tronicbaumi/PicoDeck/doc/Screenshot 2026-10-23 151857.png

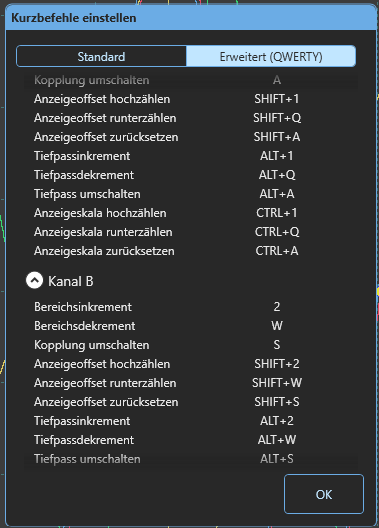
doc/Screenshot 2026-10-23 151857.png
