tronicbaumi/PicoDeck/doc/Screenshot 2026-10-23 152018.png

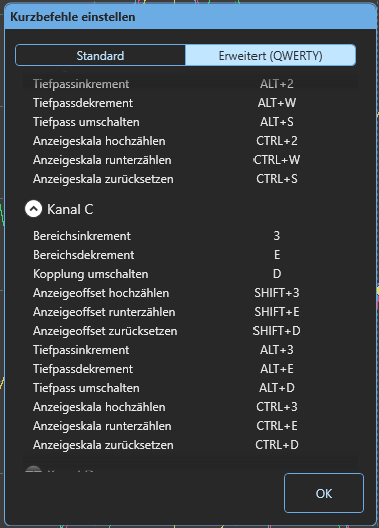
doc/Screenshot 2026-10-23 152018.png
