tronicbaumi/PicoDeck/doc/Screenshot 2026-10-23 152101.png

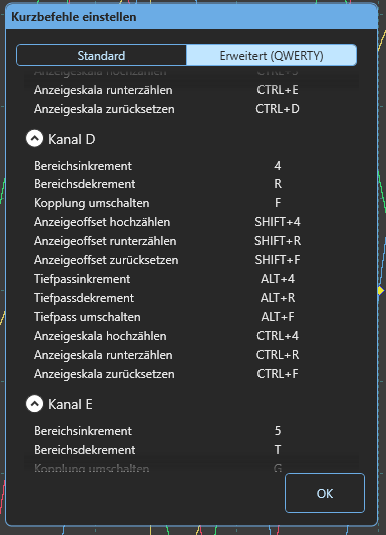
doc/Screenshot 2026-10-23 152101.png
