tronicbaumi/PicoDeck/doc/Screenshot 2026-10-23 153557.png

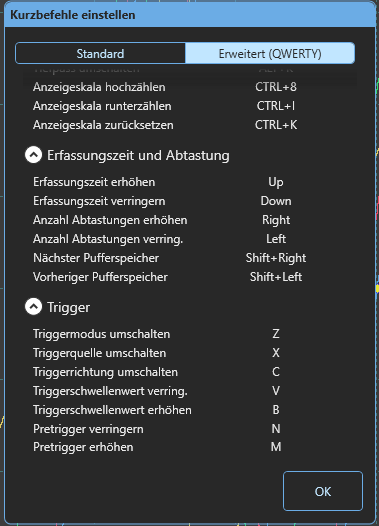
doc/Screenshot 2026-10-23 153557.png
