tronicbaumi/PicoDeck/doc/bom.txt

Arduino Micro
https://link.amazon/B075QfXTy

Buttons
https://link.amazon/B0j9Enauz

Encoder
https://link.amazon/B09QyfqTl

PCB
https://link.amazon/B01gShNRL

Buchsenleiste
https://link.amazon/B0bQtWuN1

Display
https://link.amazon/B0fDqReII

Filament
https://link.amazon/B03MNQb0l
