tronicbaumi/PicoDeck/(list of files, drawings)

Other design files:
hw/arduino_micro_panel.fz
