tronicbaumi/PicoDeck/hw/PicoDeck/PicoDeck.kicad_sch

## KiCad design hw/PicoDeck/PicoDeck.kicad_sch (2026-10-28)

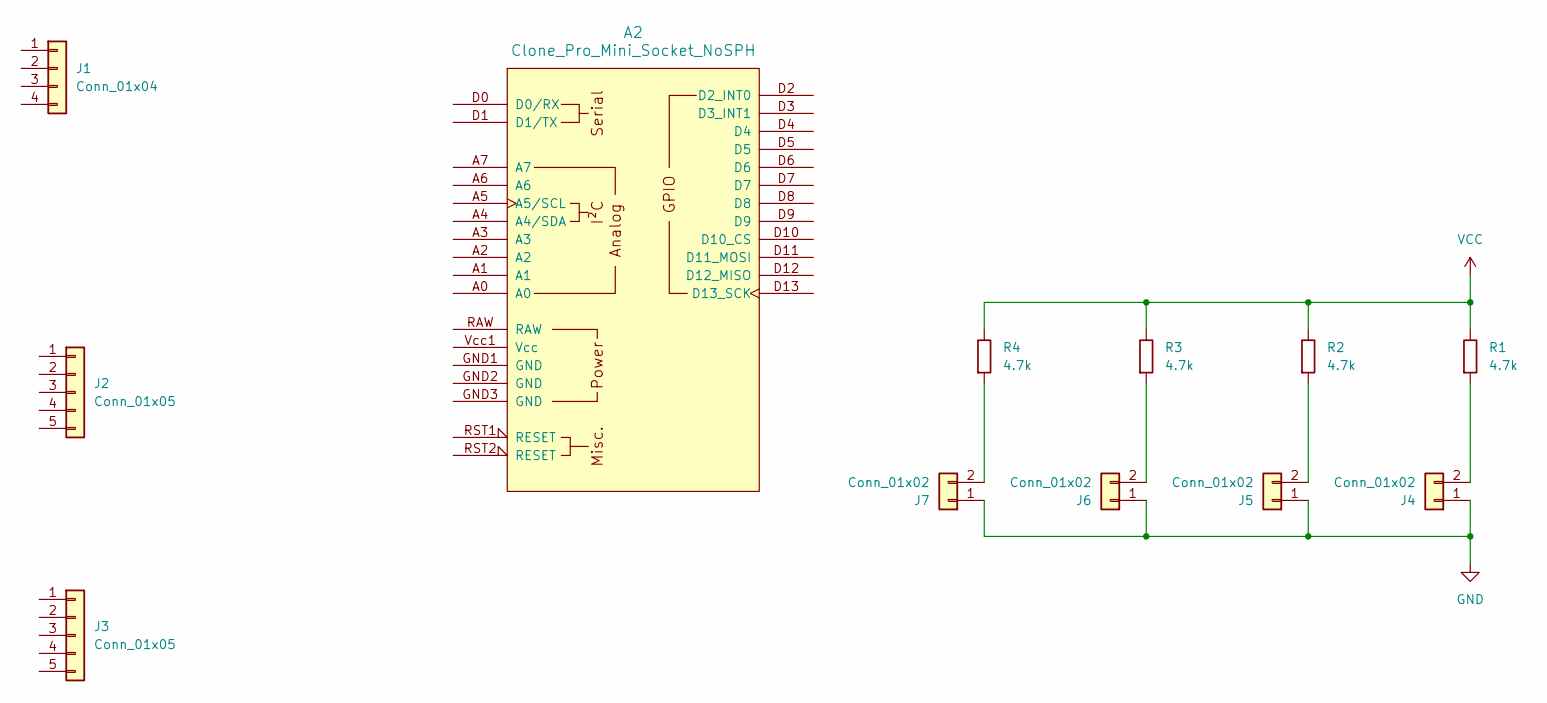
[picture p11: schematic PicoDeck.kicad_sch]

Parts:
A2: Clone_Pro_Mini_Socket_NoSPH
J1: Conn_01x04
J2, J3: Conn_01x05
J4, J5, J6, J7: Conn_01x02
R1, R2, R3, R4: 4.7k; R_Axial_DIN0207_L6.3mm_D2.5mm_P10.16mm_Horizontal

Connections:
GND: J4.1, J5.1, J6.1, J7.1
unnamed: J4.2, R1.1
unnamed: J5.2, R2.1
unnamed: J6.2, R3.1
unnamed: J7.2, R4.1
VCC: R1.2, R2.2, R3.2, R4.2
