tronicbaumi/PicoDeck/fw/PicoDeck/logo.h

// PicoScope 7 logo, 1-bit 64x64, generated from doc/PS7-logo.png
#define PS7_LOGO_WIDTH  64
#define PS7_LOGO_HEIGHT 64
static const unsigned char PROGMEM ps7_logo_bmp[] =
{
  0x00, 0x00, 0x00, 0x00, 0x00, 0x00, 0x00, 0x00, 0x0C, 0x00, 0x00, 0x00,
  0x00, 0x00, 0x40, 0x00, 0x1E, 0x0F, 0xFF, 0xF0, 0x00, 0x0F, 0xFE, 0x00,
  0x3F, 0x8F, 0xFF, 0xFC, 0x00, 0x3F, 0xFF, 0x80, 0x1E, 0x0F, 0xFF, 0xFE,
  0x00, 0x7F, 0xFF, 0xC0, 0x0E, 0x0F, 0xFF, 0xFF, 0x00, 0xFF, 0xFF, 0xE0,
  0x0E, 0x0F, 0xC0, 0x7F, 0x80, 0xFE, 0x07, 0xF0, 0x0E, 0x0F, 0x80, 0x1F,
  0xC1, 0xFC, 0x03, 0xF0, 0x0E, 0x0F, 0x80, 0x0F, 0xC1, 0xF8, 0x01, 0xF8,
  0x0E, 0x0F, 0x80, 0x0F, 0xC1, 0xF8, 0x01, 0xF8, 0x0E, 0x0F, 0x80, 0x07,
  0xC1, 0xF8, 0x00, 0x00, 0x0E, 0x0F, 0x80, 0x07, 0xC1, 0xF8, 0x00, 0x00,
  0x0E, 0x0F, 0x80, 0x07, 0xC1, 0xFE, 0x00, 0x00, 0x0E, 0x0F, 0x80, 0x0F,
  0xC0, 0xFF, 0x00, 0x00, 0x0E, 0x0F, 0x80, 0x0F, 0xC0, 0x7F, 0xE0, 0x00,
  0x0E, 0x0F, 0x80, 0x1F, 0xC0, 0x3F, 0xFC, 0x00, 0x0E, 0x0F, 0xFF, 0xFF,
  0x80, 0x1F, 0xFF, 0x00, 0x0E, 0x0F, 0xFF, 0xFF, 0x80, 0x07, 0xFF, 0xC0,
  0x0E, 0x0F, 0xFF, 0xFF, 0x00, 0x00, 0xFF, 0xE0, 0x0E, 0x0F, 0xFF, 0xFC,
  0x00, 0x00, 0x3F, 0xE0, 0x0E, 0x0F, 0xFF, 0xE0, 0x00, 0x00, 0x07, 0xF0,
  0x0E, 0x0F, 0xC0, 0x00, 0x00, 0x00, 0x03, 0xF0, 0x0E, 0x0F, 0x80, 0x00,
  0x00, 0x00, 0x01, 0xF8, 0x0E, 0x0F, 0x80, 0x00, 0x03, 0xF0, 0x01, 0xF8,
  0x0E, 0x0F, 0x80, 0x00, 0x03, 0xF0, 0x01, 0xF8, 0x0E, 0x0F, 0x80, 0x00,
  0x01, 0xF8, 0x01, 0xF8, 0x0E, 0x0F, 0x80, 0x00, 0x01, 0xFC, 0x03, 0xF0,
  0x0E, 0x0F, 0x80, 0x00, 0x01, 0xFF, 0x0F, 0xF0, 0x0E, 0x0F, 0x80, 0x00,
  0x00, 0xFF, 0xFF, 0xE0, 0x0E, 0x0F, 0x80, 0x00, 0x00, 0x7F, 0xFF, 0xC0,
  0x0E, 0x0F, 0x80, 0x00, 0x00, 0x1F, 0xFF, 0x80, 0x0E, 0x0F, 0x80, 0x00,
  0x00, 0x03, 0xFE, 0x00, 0x0E, 0x00, 0x00, 0x00, 0x00, 0x00, 0x00, 0x00,
  0x0E, 0x00, 0x00, 0x00, 0x00, 0x00, 0x00, 0x00, 0x0E, 0x00, 0x0F, 0xC0,
  0x00, 0x00, 0x00, 0x1F, 0x0E, 0x00, 0x1F, 0xF0, 0x00, 0x00, 0x00, 0x7F,
  0x0E, 0x00, 0x3F, 0xF8, 0x00, 0x00, 0x00, 0xFF, 0x0E, 0x00, 0x78, 0x3C,
  0x00, 0x00, 0x01, 0xF0, 0x0E, 0x00, 0xF0, 0x1E, 0x00, 0x00, 0x01, 0xC0,
  0x0E, 0x01, 0xE0, 0x0E, 0x00, 0x00, 0x03, 0x80, 0x0E, 0x03, 0xC0, 0x07,
  0x00, 0x00, 0x07, 0x80, 0x0E, 0x03, 0x80, 0x07, 0x80, 0x00, 0x0F, 0x00,
  0x0E, 0x07, 0x80, 0x03, 0x80, 0x00, 0x0E, 0x00, 0x0E, 0x0F, 0x00, 0x01,
  0xC0, 0x00, 0x1E, 0x00, 0x0E, 0x0E, 0x00, 0x01, 0xE0, 0x00, 0x1C, 0x00,
  0x0E, 0x1E, 0x00, 0x00, 0xE0, 0x00, 0x38, 0x00, 0x0E, 0x1C, 0x00, 0x00,
  0xF0, 0x00, 0x78, 0x00, 0x0E, 0x38, 0x00, 0x00, 0x70, 0x00, 0x70, 0x00,
  0x0E, 0x78, 0x00, 0x00, 0x38, 0x00, 0xF0, 0x00, 0x0E, 0xF0, 0x00, 0x00,
  0x3C, 0x01, 0xE0, 0x00, 0x0F, 0xE0, 0x00, 0x00, 0x1E, 0x03, 0xC0, 0x00,
  0x0F, 0xE0, 0x00, 0x00, 0x0F, 0x07, 0x80, 0x00, 0x0F, 0xC0, 0x00, 0x00,
  0x07, 0xFF, 0x00, 0x00, 0x0F, 0x80, 0x00, 0x00, 0x03, 0xFE, 0x00, 0x00,
  0x0E, 0x00, 0x00, 0x00, 0x01, 0xFC, 0x00, 0x00, 0x0E, 0x00, 0x00, 0x00,
  0x00, 0x00, 0x00, 0x08, 0x0E, 0x00, 0x00, 0x00, 0x00, 0x00, 0x00, 0x08,
  0x0F, 0xFF, 0xFF, 0xFF, 0xFF, 0xFF, 0xFF, 0xFC, 0x0F, 0xFF, 0xFF, 0xFF,
  0xFF, 0xFF, 0xFF, 0xFE, 0x0F, 0xFF, 0xFF, 0xFF, 0xFF, 0xFF, 0xFF, 0xFE,
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
};
