tronicbaumi/PicoDeck/(commit log)

2026-10-22 major arduino update
2026-10-24 added openSCAD housing
2026-10-24 housing display update
2026-10-26 encoder and button holes adjusted
2026-10-27 housing update
    button diameter 12mm
    PCB hole adjustment
2026-10-28 schematics started
